tahaekim/ELEC310-Project/LTSpice/Astable_Multivibrator.asc

C1: Cap; 10µ
C2: Cap; 10µ
D1: LED; QTLP690C
D2: LED; QTLP690C
Q1: npn; 2N3904
Q2: npn; 2N3904
R1: Res; 1k
R2: Res; 47k
R3: Res; 47k
R4: Res; 1k
V1: Voltage; 9V
Named nets: 0
.tran 3
